openxc/shiftknob-hardware/docs/BOM_BottomPCB_v02.xls

Ford Motor Company | Research and Innovation Center |  |  |  |  | Please call to confirm any issues or questions before proceeding
BOM: | BottomPCB-v02
Date: | 2013-03-26
Assignee: | Zachary Nelson znelson1@ford.com
Item | QTY/BOARD | Reference Designation | Value | Description | Package | Manfr. or Distributor description/specs | Manfacturer | Manfr. P/N: | Distrutor | Distributor P/N
1 | 5 | C1, C2, C3, C4, C5 | 0.1uF | Capacitor | 0402 (1005 Metric) | CAP CER 0.1UF 16V 10% X5R 0402 | AVX Corporation | 0402YD104KAT2A | DIGIKEY | 478-1126-1-ND
2 | 2 | C10, C6 | 10uF | Capacitor - Polarized | 1206 (3216 Metric) | CAP TANT 10UF 16V 10% 1206 | Nichicon | F931C106KAA | DIGIKEY | 493-4147-1-ND
3 | 3 | LED1, LED2, LED3 | none | RGB LED - RIGHTANGLE | 4-SMD, No Lead | LED CHIP RGB 2.5X1.0X1.0MM SMD | Avago Technologies | HSMF-C113 | DIGIKEY | 516-2232-1-ND
4 | 1 | U1 (ATMEGA328) | none | IC - Atmega328 | 32-pin SMD | MCU AVR 32K FLASH 15MHZ 32-TQFP | Atmel | ATMEGA328P-15AZ | DIGIKEY | ATMEGA328P-15AZCT-ND
5 | 1 | Q1 | 16MHz | 16MHz clock | 3-SMD, Non-Standard | CER RESONATOR 16.0MHZ SMD | Murata Electronics North America | CSTCE16M0V53-R0 | DIGIKEY | 490-1198-1-ND
6 | 1 | IC2 | none | 7805 linear regulator | SOT-223 | IC REG LDO 5V .5A SOT-223 | Texas Instruments | UA78M05CDCYR | DIGIKEY | 296-12290-1-ND
7 | 5 | Q2, Q4, Q5, Q6 | none | MOSFET-NCHANNELSMD | SOT-23-3 | MOSFET N-CH 20V 4.2A SOT23 | Diodes Inc | DMG2302U-7 | DIGIKEY | DMG2302U-7DICT-ND
8 | 1 | Q3 | none | MOSFET-PCHANNELSMD | SOT-23-3 | MOSFET P-CH 20V 4.2A SOT-23 | Diodes Inc | DMP2305U-7 | DIGIKEY | DMP2305UDICT-ND
9 | 2 | D1, D2 | none | Schottky Diode | SOD123 | DIODE SCHOTTKY 0.5A 20V SOD-123 | ON Semiconductor | MBR0520LT3G | DIGIKEY | MBR0520LT3GOSCT-ND
10 | 1 | LED7 | none | Green LED | 0603 (1608 Metric) | LED 1.6X0.8MM 568NM GRN CLR SMD | Kingbright Corp | APT1608SGC | DIGIKEY | 754-1121-1-ND
11 | 1 | LED6 | none | Red LED | 0603 (1608 Metric) | LED 1.6X0.8MM 625NM RED CLR SMD | Kingbright Corp | APT1608EC | DIGIKEY | 754-1117-1-ND
12 | 3 | R2, R13, R14 | 10kΩ | Resistor | 0402 (1005 Metric) | RES 10K OHM 1/16W 5% 0402 SMD | Stackpole Electronics Inc | RMCF0402JT10K0 | DIGIKEY | RMCF0402JT10K0CT-ND
13 | 2 |  | 1kΩ | Resistor (for TX and RX LEDs) | 0402 (1005 Metric) | RES 1K OHM 1/16W 5% 0402 | Stackpole Electronics Inc | RMCF0402JT1K00 | DIGIKEY | RMCF0402JT1K00CT-ND
14 | 2 | RN1, RN2 | 150Ω | Resistor Array | 2008, Concave (0805) | RES ARRAY 150 OHM 4 RES 2008 | CTS Resistor Products | 743C083151JP | DIGIKEY | 743C083151JPCT-ND
15 | 1 | RN3 | 100Ω | Resistor Array | 2008, Concave (0805) | RES ARRAY 100 OHM 4 RES 2008 | CTS Resistor Products | 743C083101JP | DIGIKEY | 743C083101JPCT-ND
16 | 1 | BUTTON | none | Edge Button | 6.20mm x 2.55mm | SWITCH TACTILE SPST-NO 0.02A 15V | Panasonic Electronic Components | EVQ-P4H03B | DIGIKEY | P12305SCT-ND
17 | 2 | JP4 | none | Connector - Receptacle | 2.0mm pitch | CONN HEADER 2POS 2MM R/A SMD | Molex Inc | #5023520200 | DIGIKEY | WM7169CT-ND
18 | 1 | not on board | none | Connector - Plug | 2.0mm pitch | CONN 2.0 W/B REC HSG 2CKT | Molex Inc | #5023510200 | DIGIKEY | 5023510200-ND
19 | 1 | U6 | none | USB Vertical | Through Hole - Vertical | CONN MINI USB 5PIN VERT T/H | Wurth Electronics Inc | #651005136421 | DIGIKEY | 732-2735-ND
20 | 1 | U3 | none | FT232RL | 28-SSOP | IC USB FS SERIAL UART 28-SSOP | FTDI | FT232RL-REEL | DIGIKEY | 768-1007-1-ND
