openxc/shiftknob-hardware/docs/BOM_TopPCB_v02.xls

Ford Motor Company | Research and Innovation Center |  |  |  | Please call to confirm any issues or questions before proceeding
BOM: | TopPCB-v02
Date: | 2013-04-08
Assignee: | Zachary Nelson (313) 920-8701
Item | QTY/BOARD | Reference Designation | Value | Description | Package | Manfr. or Distributor description/specs | Manfacturer | Manfr. P/N: | Distrutor | Distributor P/N
1 | 2 | ARRAY1, ARRAY2 | 220Ω | Resistor Array | 2012 (5131 Metric), Concave | RES ARRAY 220 OHM 4 RES 2012 | CTS Resistor Products | 744C083221JP | DIGIKEY | 744C083221JPCT-ND
2 | 1 | C1 | 0.1uF | Capacitor | 0402 (1005 Metric) | CAP CER 0.1UF 16V 10% X5R 0402 | AVX Corporation | 0402YD104KAT2A | DIGIKEY | 478-1126-1-ND
3 | 1 | SHIFT1 | 74HC595D | 8-bit SHIFT REGISTER, output latch | 16-SOIC (0.154", 3.90mm Width) | IC 8BIT SHIFT REG 3ST-OUT 16SOIC | Texas Instruments | SN74HC595DR | DIGIKEY | 296-14857-1-ND
4 | 2 | LOWER, UPPER | none | 4-pin male header | 0.1" pitch
5 | 1 | 7SEGMENT | none | 7 Segment LED Display | 2 x 5 pin through hole | 7-Segment Display - LED (BLUE) | www.100LED.com | YSD-160AB3C-8 | Sparkfun | COM-09191
