openxc/shiftknob-hardware/docs/BottomPCB_schematic_v02.pdf

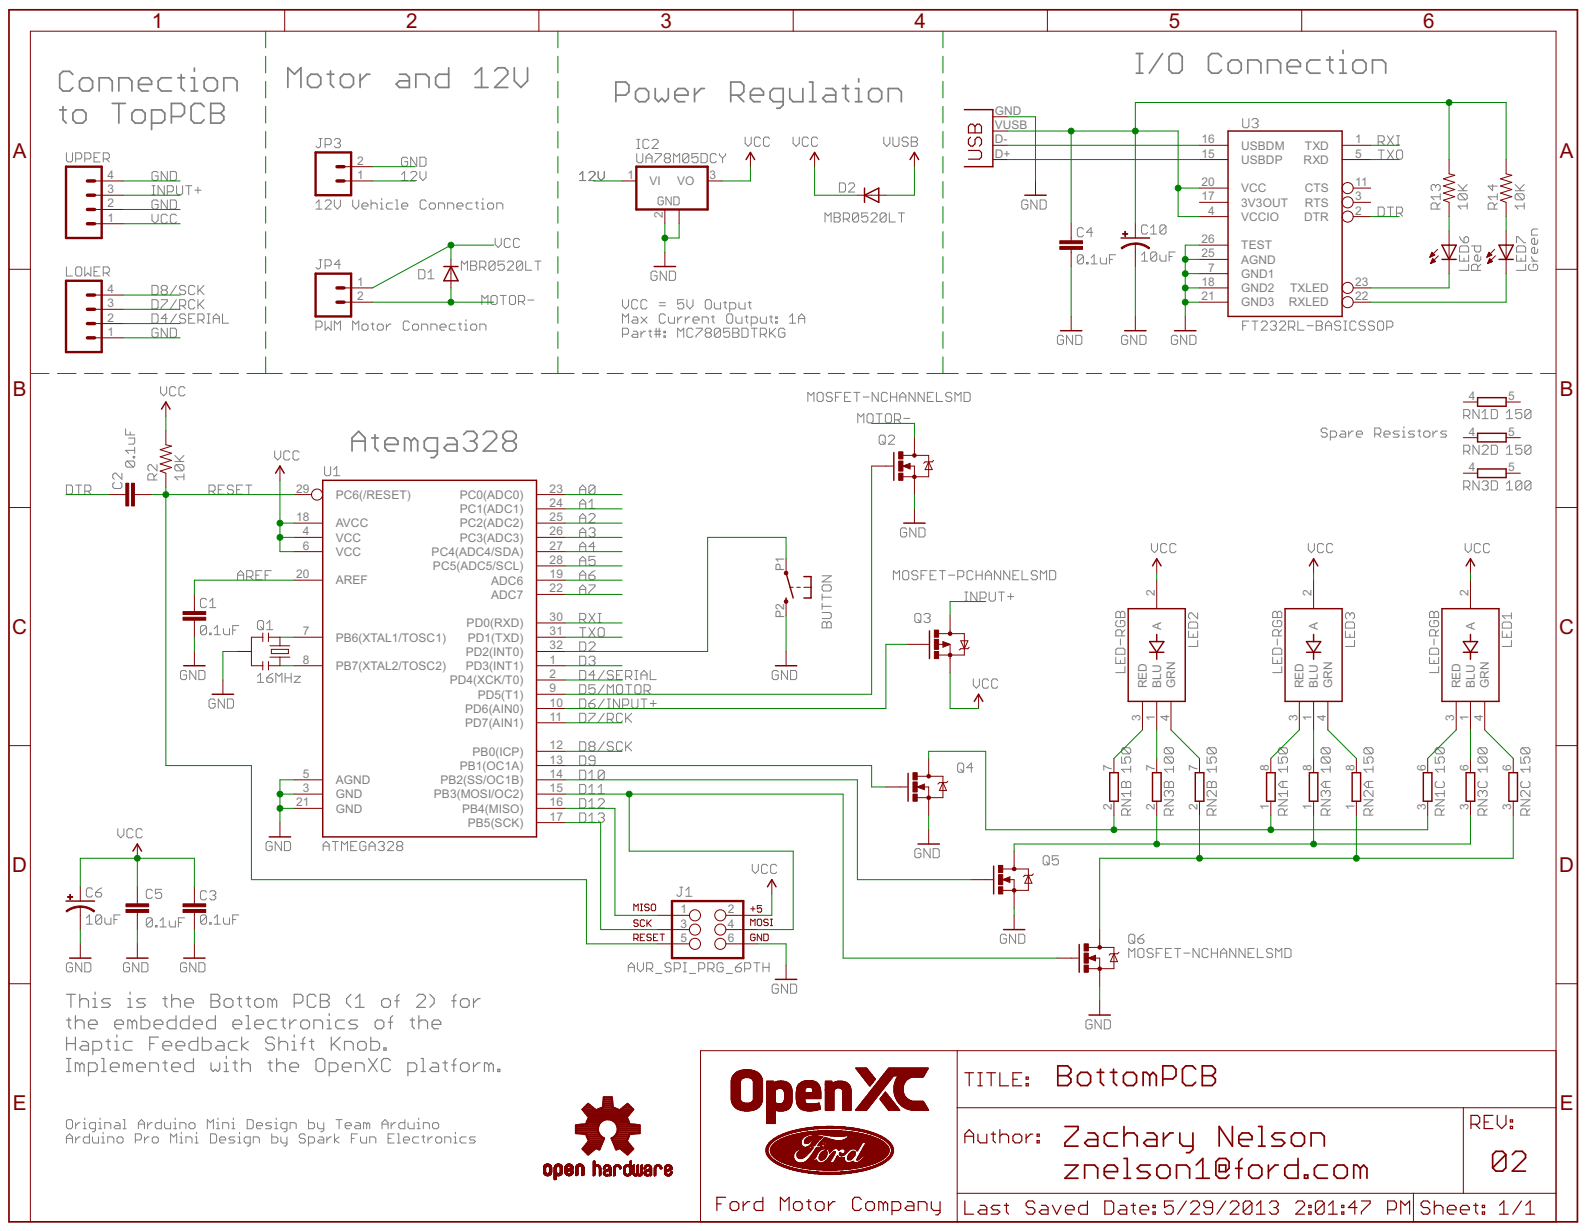
[picture p1: page 1]
