openxc/shiftknob-hardware/docs/TopPCB_schematic_v02.pdf

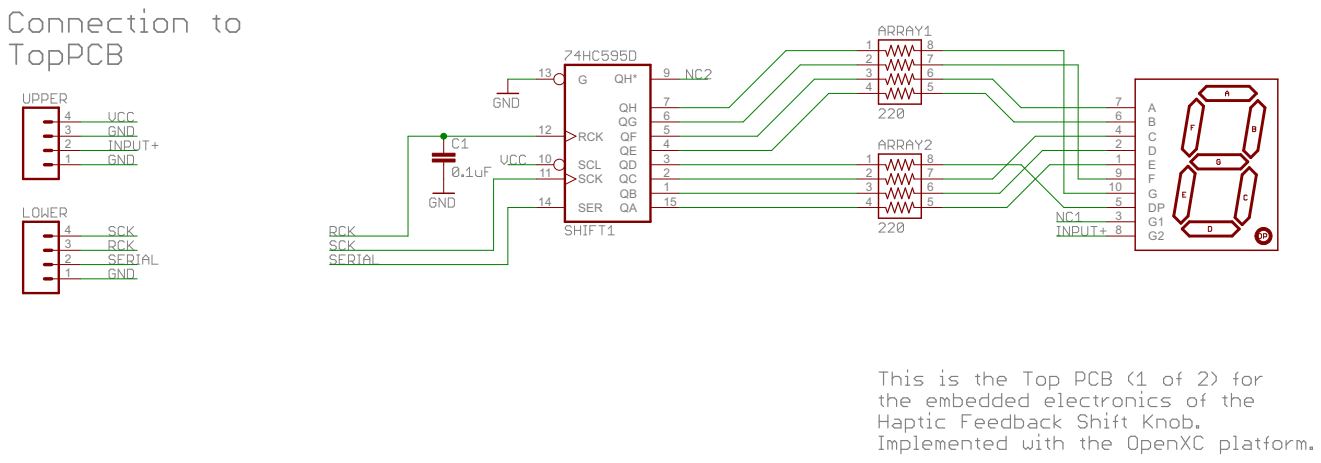
[picture p2: page 1]
