openxc/shiftknob-hardware/docs/BottomPCB_layout_v02.pdf

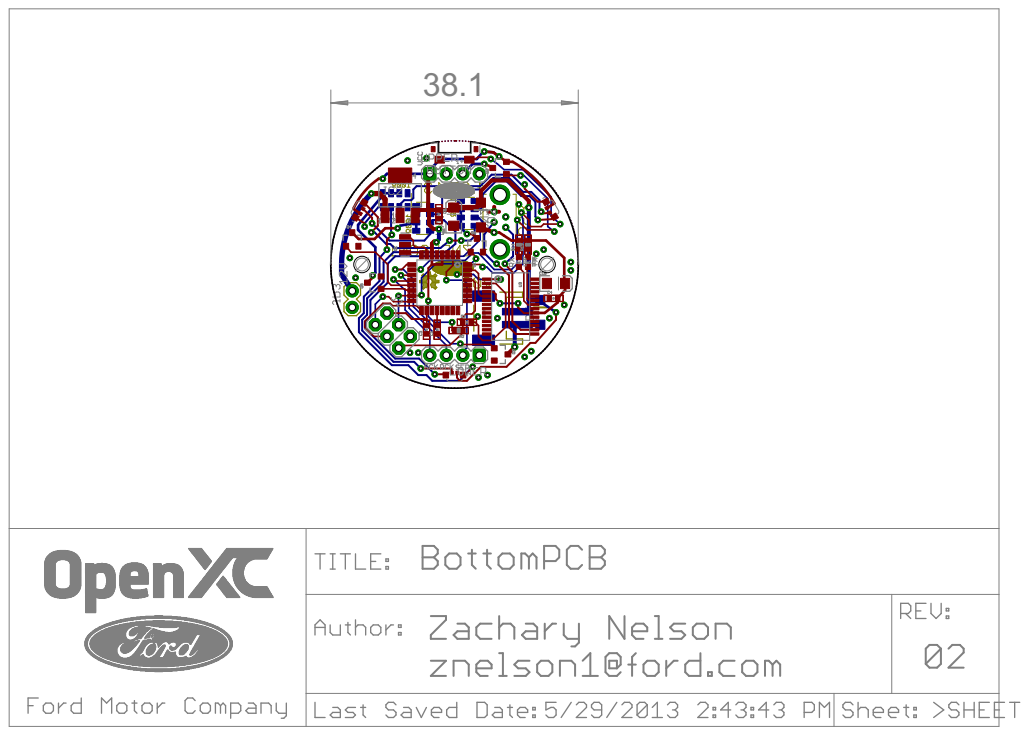
[picture p3: page 1]
