openxc/shiftknob-hardware/docs/TopPCB_layout_v02.pdf

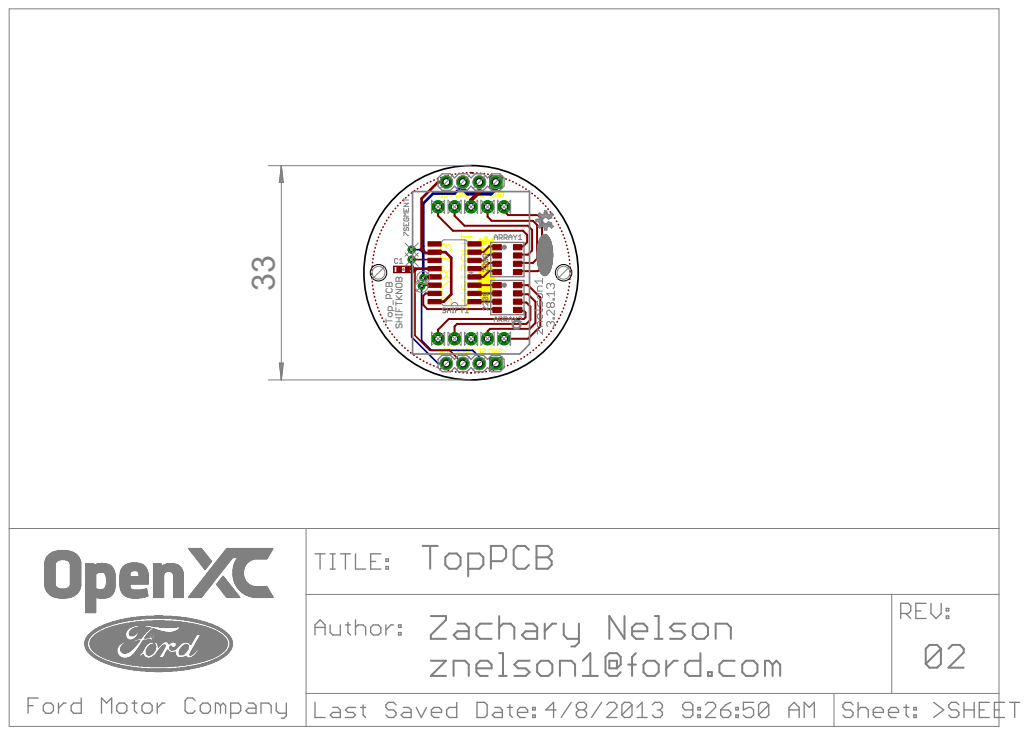
[picture p4: page 1]
