openxc/shiftknob-hardware/docs/BottomPCB_schematic_V01.pdf

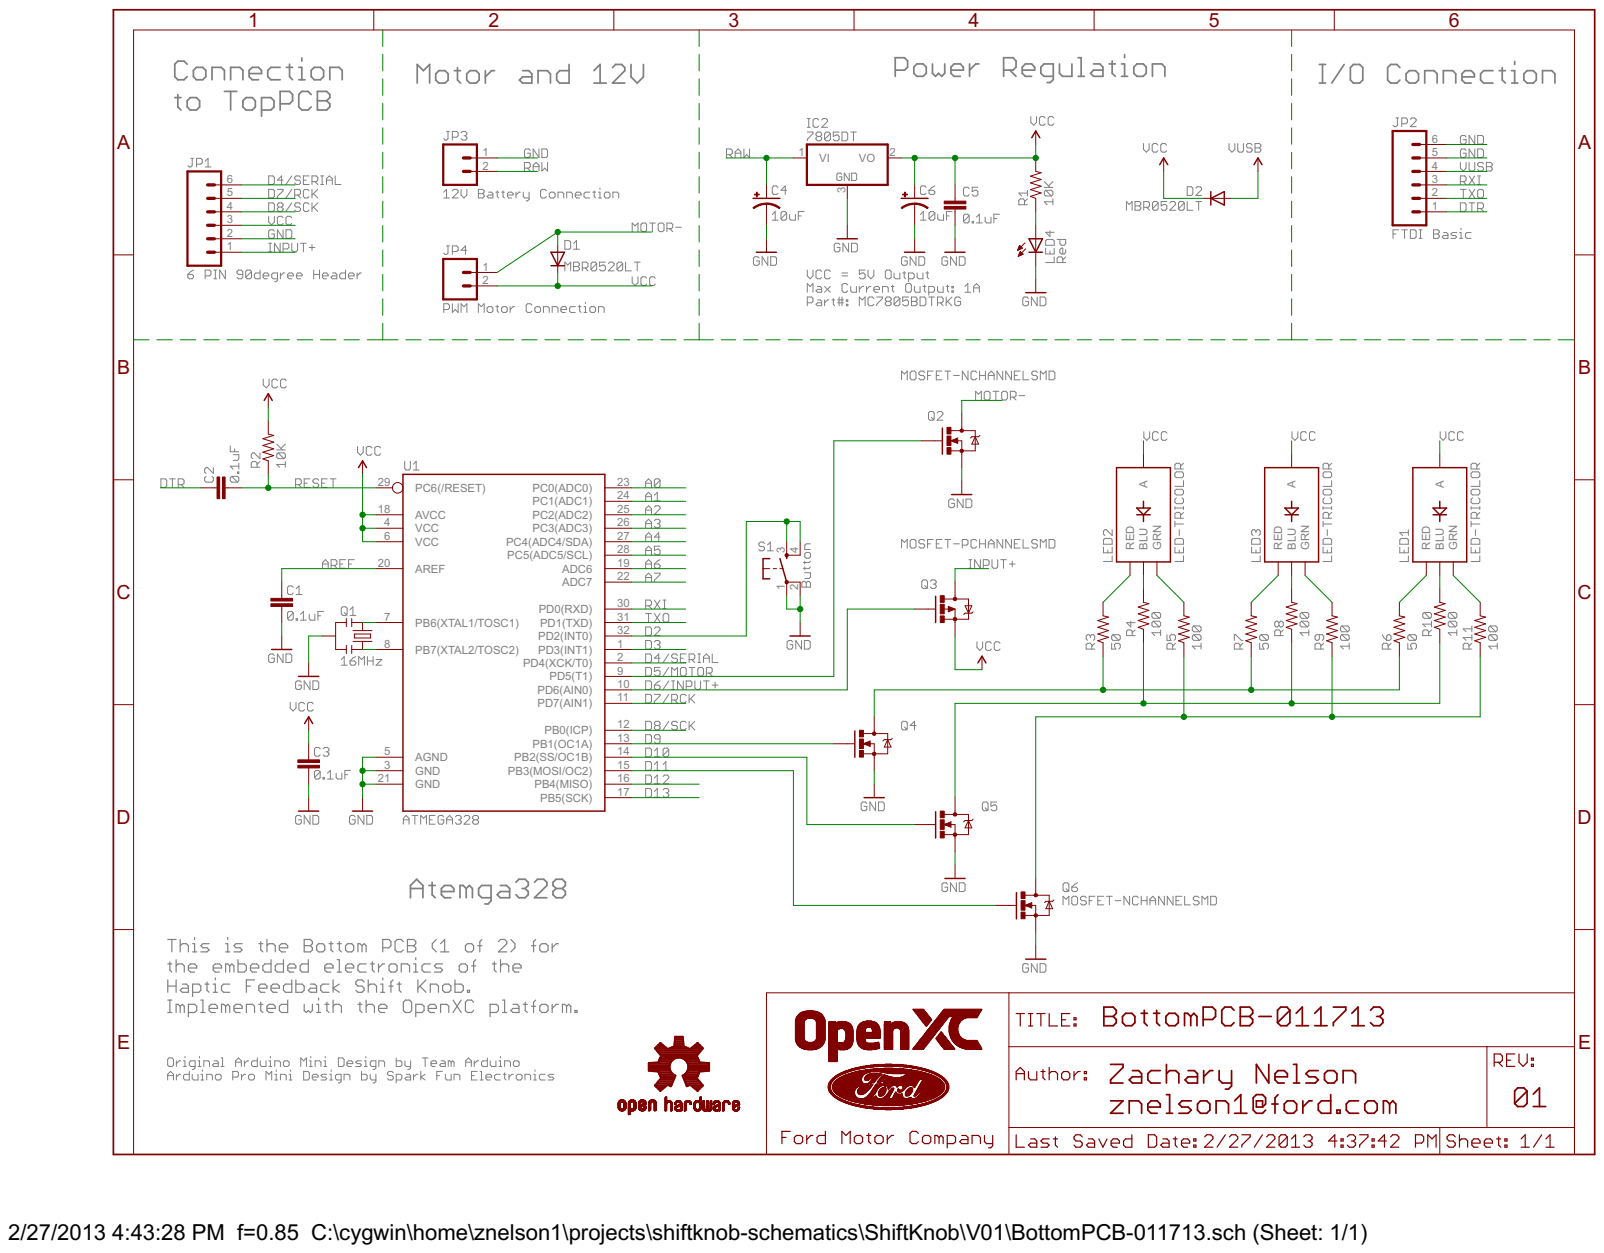
[picture p5: page 1]

2/27/2013 4:43:28 PM f=0.85 C:\cygwin\home\znelson1\projects\shiftknob-schematics\ShiftKnob\V01\BottomPCB-011713.sch (Sheet: 1/1)
