openxc/shiftknob-hardware/docs/TopPCB_schematic_V01.pdf

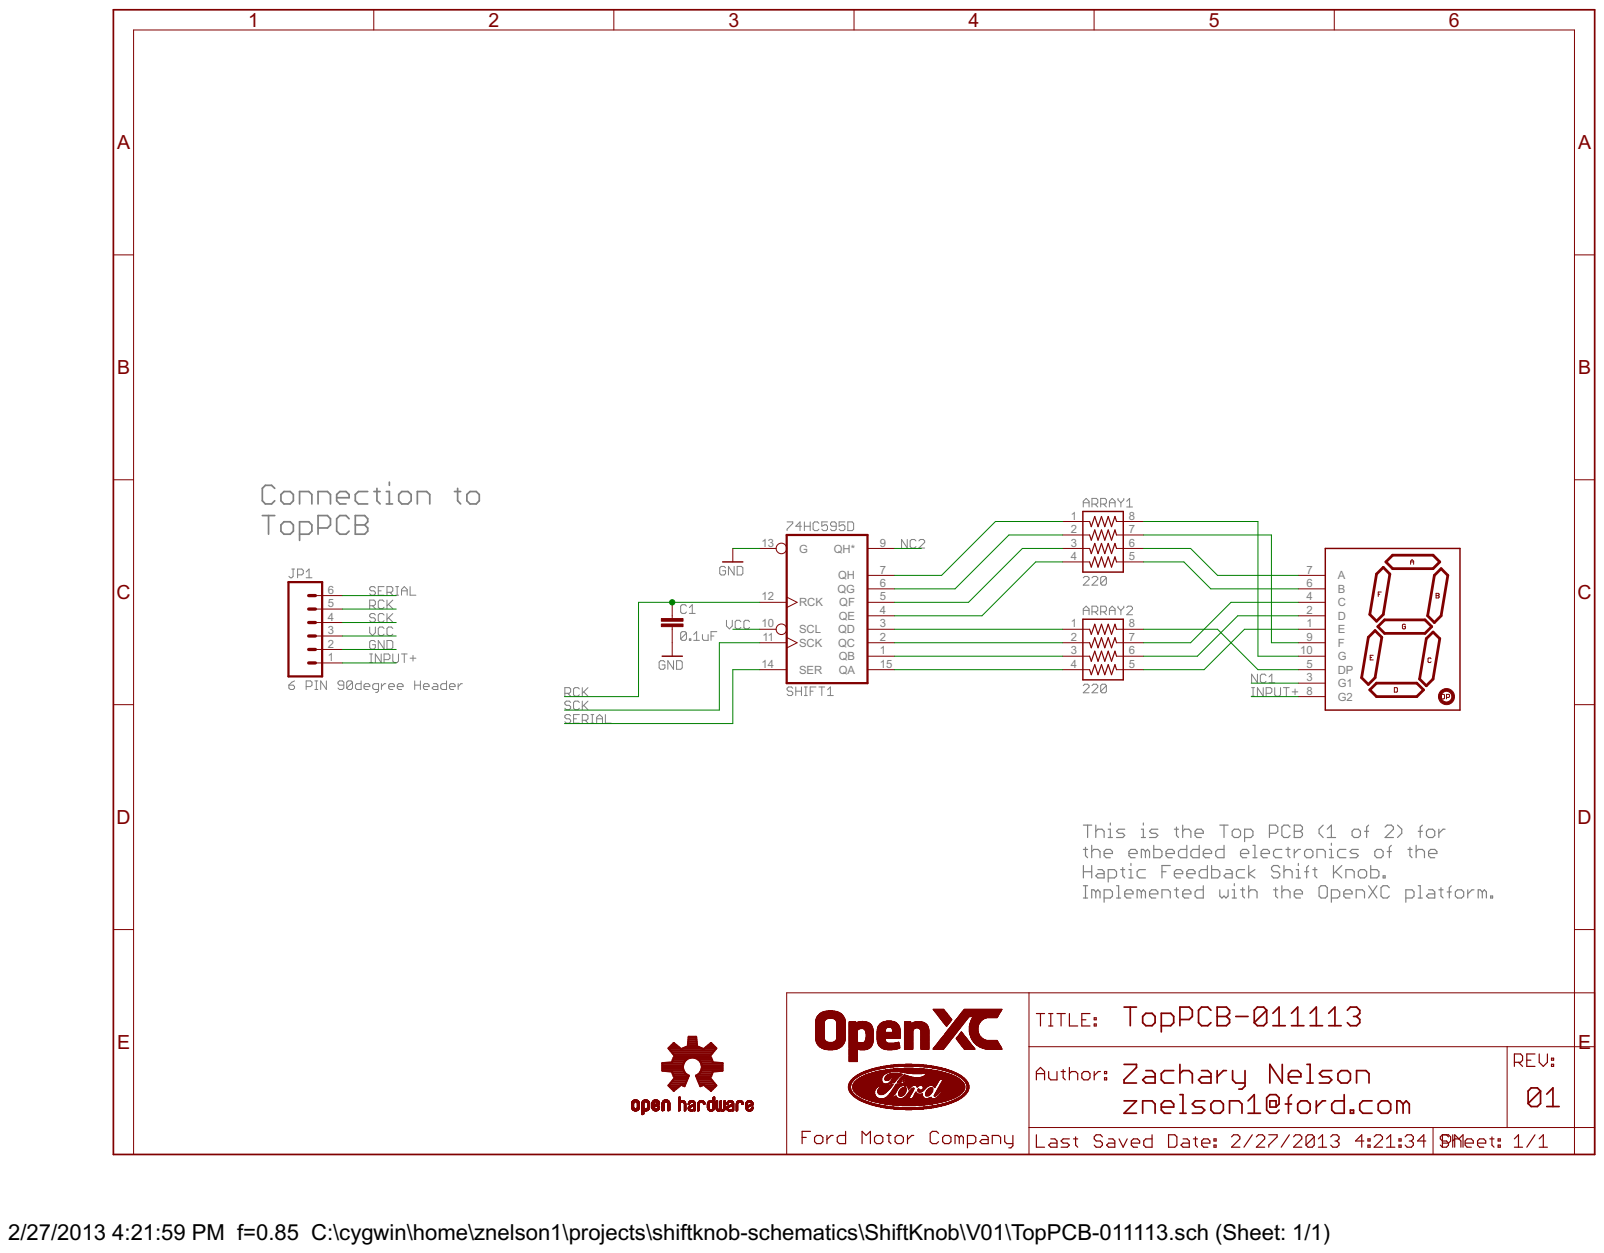
[picture p6: page 1]

2/27/2013 4:21:59 PM f=0.85 C:\cygwin\home\znelson1\projects\shiftknob-schematics\ShiftKnob\V01\TopPCB-011113.sch (Sheet: 1/1)
