openxc/shiftknob-hardware/docs/BottomPCB_layout_v01.pdf

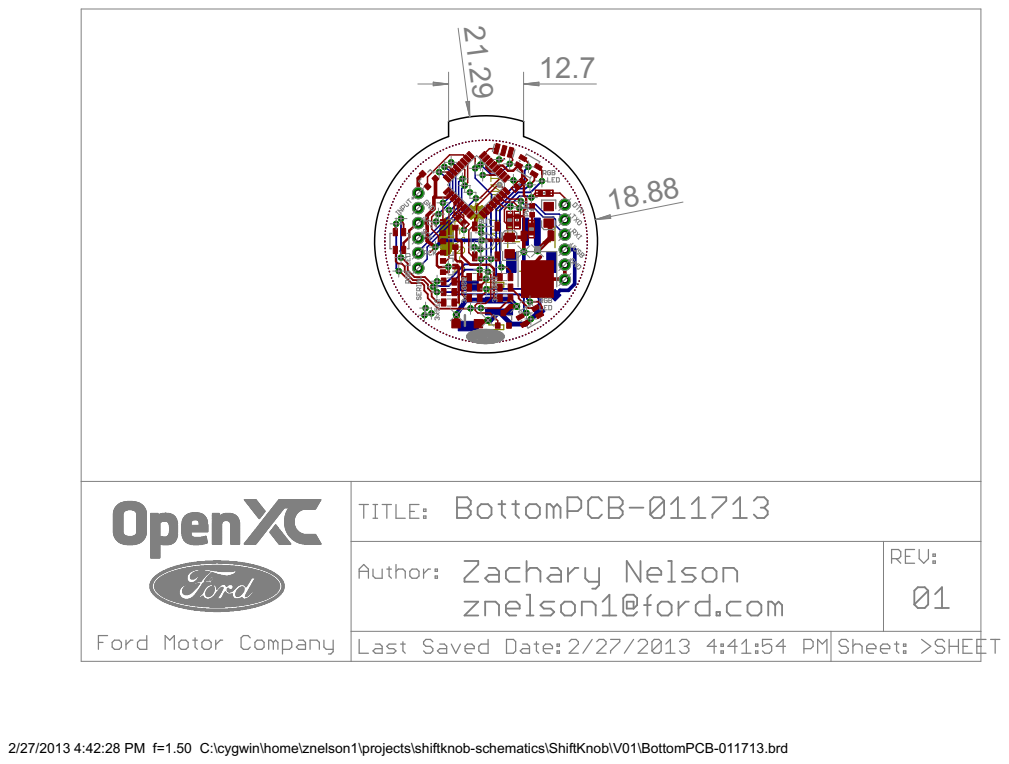
[picture p7: page 1]

2/27/2013 4:42:28 PM f=1.50 C:\cygwin\home\znelson1\projects\shiftknob-schematics\ShiftKnob\V01\BottomPCB-011713.brd
