openxc/shiftknob-hardware/TopPCB.brd

## EAGLE design TopPCB.brd (2013-04-08)

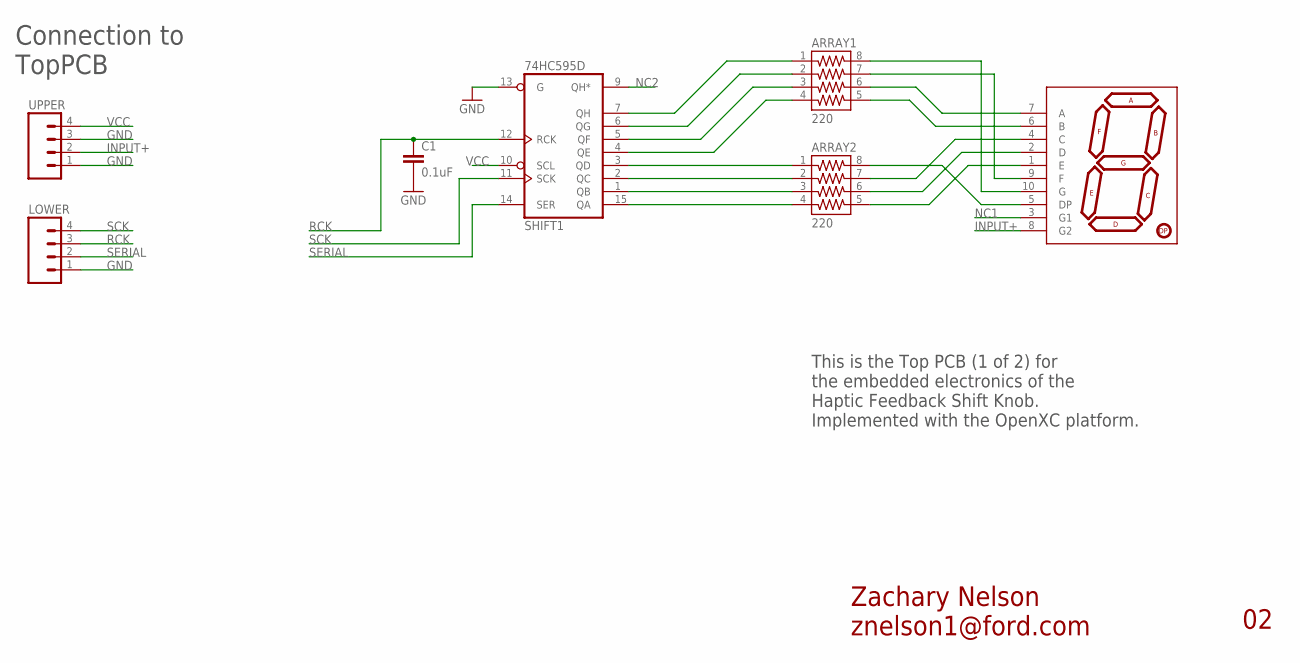
[picture p8: schematic TopPCB.sch]

Parts:
7SEGMENT: 7-SEGMENT-DISPLAY-1"-RED; 7-SEGMENT-1"PTH
ARRAY1, ARRAY2: 220; 744-8
C1: 0.1uF; 0402-CAP
LOWER: M04PTH; 1X04
SHIFT1: 74HC595D; SO16
UPPER: M04PTH; 1X04

Connections:
GND: C1.2, LOWER.1, SHIFT1.8 (GND), SHIFT1.13 (G), UPPER.1, UPPER.3
INPUT+: 7SEGMENT.8 (G2), UPPER.2
unnamed: 7SEGMENT.5 (DP), ARRAY2.8
unnamed: ARRAY2.3, SHIFT1.1 (QB)
unnamed: 7SEGMENT.1 (E), ARRAY2.5
unnamed: ARRAY2.2, SHIFT1.2 (QC)
unnamed: ARRAY2.1, SHIFT1.3 (QD)
unnamed: 7SEGMENT.4 (C), ARRAY2.7
unnamed: 7SEGMENT.6 (B), ARRAY1.5
unnamed: ARRAY2.4, SHIFT1.15 (QA)
unnamed: ARRAY1.4, SHIFT1.4 (QE)
unnamed: ARRAY1.3, SHIFT1.5 (QF)
unnamed: ARRAY1.2, SHIFT1.6 (QG)
unnamed: ARRAY1.1, SHIFT1.7 (QH)
unnamed: 7SEGMENT.7 (A), ARRAY1.6
unnamed: 7SEGMENT.9 (F), ARRAY1.7
unnamed: 7SEGMENT.10 (G), ARRAY1.8
unnamed: 7SEGMENT.2 (D), ARRAY2.6
NC1: 7SEGMENT.3 (G1)
NC2: SHIFT1.9 (QH*)
RCK: C1.1, LOWER.3, SHIFT1.12 (RCK)
SCK: LOWER.4, SHIFT1.11 (SCK)
SERIAL: LOWER.2, SHIFT1.14 (SER)
VCC: SHIFT1.10 (SCL), SHIFT1.16 (VCC), UPPER.4

Notes on the sheet:
Zachary Nelson znelson1@ford.com
This is the Top PCB (1 of 2) for the embedded electronics of the Haptic Feedback Shift Knob. Implemented with the OpenXC platform.
Connection to TopPCB

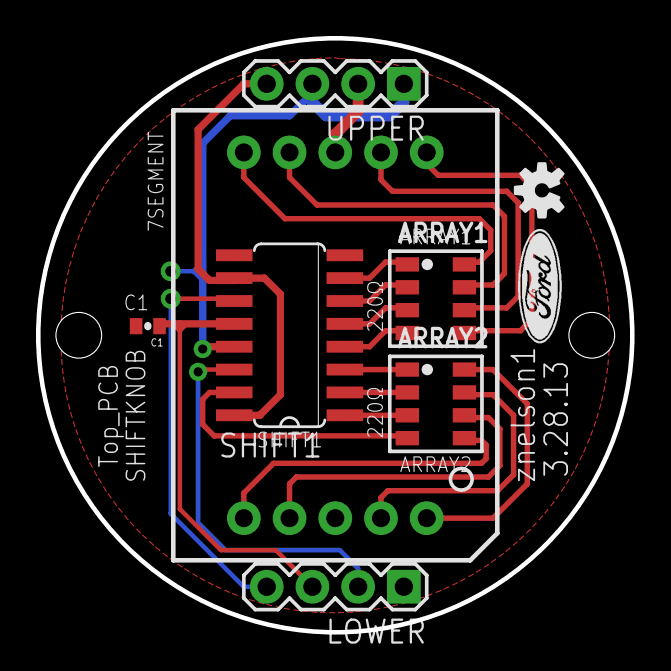
[picture p9: board TopPCB.brd from above]

Board: 2 copper layers, 33.0 x 33.0 mm, 10 parts (1 on the bottom side), 22 nets.

Other parts of the board:
U$1, U$2: OSHW-LOGOS; OSHW-LOGO-S
U$3: DOCFIELD
