openxc/shiftknob-hardware/BottomPCB.brd

## EAGLE design BottomPCB.brd (2013-05-29)

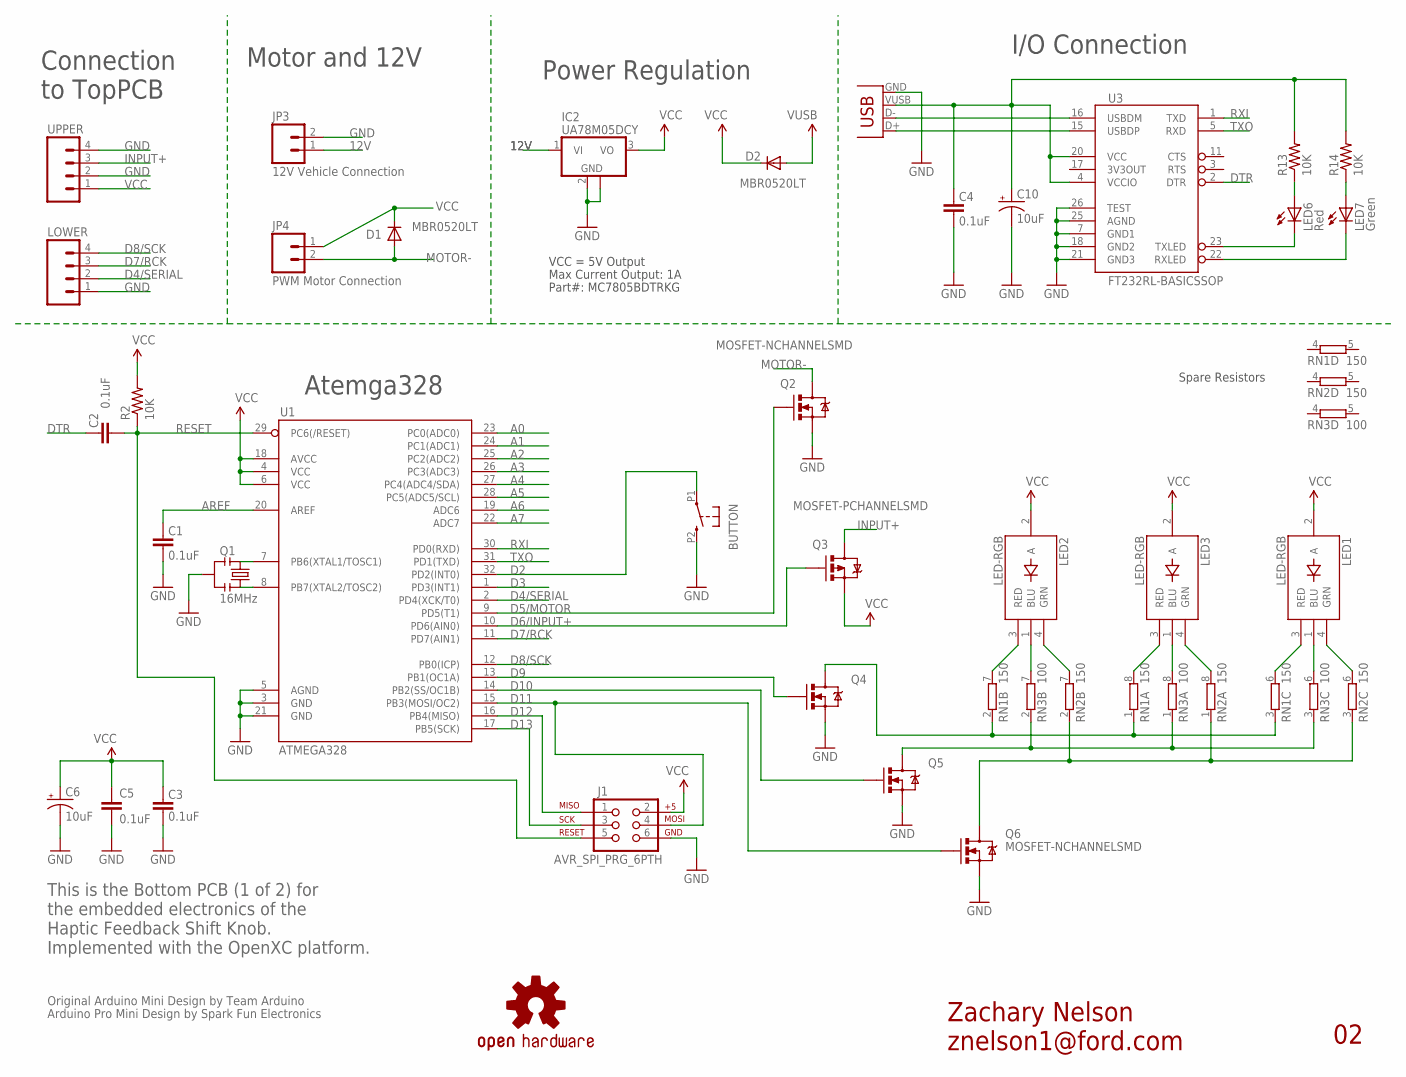
[picture p10: schematic BottomPCB.sch]

Parts:
BUTTON: BUTTON_EDGE
C1, C2, C3, C4, C5: 0.1uF; 0402-CAP
C6, C10: 10uF; EIA3216
D1, D2: MBR0520LT; SOD123
IC2: UA78M05DCY; SOT223
J1: AVR_SPI_PRG_6PTH; 2X3
JP3: 12V Vehicle Connection; 1X02
JP4: PWM Motor Connection; JST-2-SMD
LED1, LED2, LED3: LED-RGB; LED-RGB_SMD-RIGHTANGLE
LED6: Red; LED-0603
LED7: Green; LED-0603
LOWER: M04PTH; 1X04
Q1: 16MHz; RESONATOR-SMD
Q2, Q4, Q5, Q6: MOSFET-NCHANNELSMD; SOT23-3
Q3: MOSFET-PCHANNELSMD; SOT23-3
R2, R13, R14: 10K; 0402-RES
RN1, RN2: 150; EXBS8V
RN3: 100; EXBS8V
U1: ATMEGA328; TQFP32-08
U3: FT232RL-BASICSSOP; SSOP28DB
U6: USB-MINI-B_VERTICAL
U$3: OSHW-LOGOS; OSHW-LOGO-S
UPPER: M04PTH; 1X04

Connections:
12V: IC2.1 (VI), JP3.1
A0: U1.23 (PC0(ADC0))
A1: U1.24 (PC1(ADC1))
A2: U1.25 (PC2(ADC2))
A3: U1.26 (PC3(ADC3))
A4: U1.27 (PC4(ADC4/SDA))
A5: U1.28 (PC5(ADC5/SCL))
A6: U1.19 (ADC6)
A7: U1.22 (ADC7)
AREF: C1.2, U1.20 (AREF)
D2: BUTTON.P1 (1), U1.32 (PD2(INT0))
D3: U1.1 (PD3(INT1))
D4/SERIAL: LOWER.2, U1.2 (PD4(XCK/T0))
D5/MOTOR: Q2.1 (G), U1.9 (PD5(T1))
D6/INPUT+: Q3.1 (G), U1.10 (PD6(AIN0))
D7/RCK: LOWER.3, U1.11 (PD7(AIN1))
D8/SCK: LOWER.4, U1.12 (PB0(ICP))
D9: Q4.3 (D), RN1.1, RN1.2 (1), RN1.3 (1)
D10: Q5.3 (D), RN3.1, RN3.2 (1), RN3.3 (1)
D11: Q6.3 (D), RN2.1, RN2.2 (1), RN2.3 (1)
D12: J1.1, U1.16 (PB4(MISO))
D13: J1.3, U1.17 (PB5(SCK))
DTR: C2.2, U3.2 (DTR)
GND: BUTTON.P2 (2), C1.1, C3.1, C4.1, C5.2, C6.C (-), C10.C (-), IC2.2 (GND), IC2.4 (GND), J1.6, JP3.2, LOWER.1, Q1.2, Q2.2 (S), Q4.2 (S), Q5.2 (S), Q6.2 (S), U1.3 (GND), U1.5 (AGND), U1.21 (GND), U3.7 (GND1), U3.18 (GND2), U3.21 (GND3), U3.25 (AGND), U3.26 (TEST), U6.GND, UPPER.2, UPPER.4
INPUT+: Q3.3 (D), UPPER.3
MOTOR-: D1.A, JP4.2 (1), Q2.3 (D)
unnamed: Q1.1, U1.8 (PB7(XTAL2/TOSC2))
unnamed: Q1.3, U1.7 (PB6(XTAL1/TOSC1))
unnamed: LED2.3 (RED), RN1.7 (2)
unnamed: LED2.4 (GRN), RN2.7 (2)
unnamed: LED3.3 (RED), RN1.8 (2)
unnamed: LED1.1 (BLU), RN3.6 (2)
unnamed: LED3.4 (GRN), RN2.8 (2)
unnamed: LED1.3 (RED), RN1.6 (2)
unnamed: LED1.4 (GRN), RN2.6 (2)
unnamed: Q4.1 (G), U1.13 (PB1(OC1A))
unnamed: Q5.1 (G), U1.14 (PB2(SS/OC1B))
unnamed: J1.4, Q6.1 (G), U1.15 (PB3(MOSI/OC2))
unnamed: LED2.1 (BLU), RN3.7 (2)
unnamed: LED3.1 (BLU), RN3.8 (2)
unnamed: U3.15 (USBDP), U6.D+
unnamed: U3.16 (USBDM), U6.D-
unnamed: LED6.A, R13.1
unnamed: LED7.A, R14.1
RESET: C2.1, J1.5, R2.1, U1.29 (PC6(/RESET))
RXI: U1.30 (PD0(RXD)), U3.1 (TXD)
RXLED1: LED7.C, U3.22 (RXLED)
TXLED1: LED6.C, U3.23 (TXLED)
TXO: U1.31 (PD1(TXD)), U3.5 (RXD)
VCC: C3.2, C5.1, C6.A (+), D1.C, D2.C, IC2.3 (VO), J1.2, JP4.1 (2), LED1.2 (A), LED2.2 (A), LED3.2 (A), Q3.2 (S), R2.2, U1.4 (VCC), U1.6 (VCC), U1.18 (AVCC), UPPER.1
VUSB: C4.2, C10.A (+), D2.A, R13.2, R14.2, U3.4 (VCCIO), U3.20 (VCC), U6.VUSB (VBUS)

Notes on the sheet:
Zachary Nelson znelson1@ford.com
Original Arduino Mini Design by Team Arduino
Arduino Pro Mini Design by Spark Fun Electronics
Max Current Output: 1A
VCC = 5V Output
Part#: MC7805BDTRKG
Power Regulation
I/O Connection
Motor and 12V
Atemga328
Connection to TopPCB
This is the Bottom PCB (1 of 2) for the embedded electronics of the Haptic Feedback Shift Knob. Implemented with the OpenXC platform.
Spare Resistors

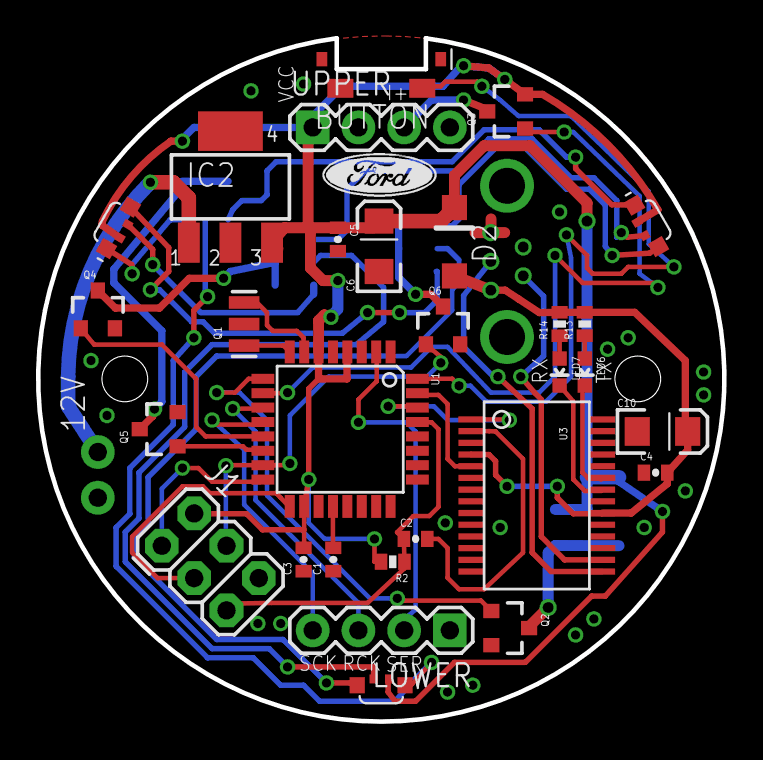
[picture p11: board BottomPCB.brd from above]

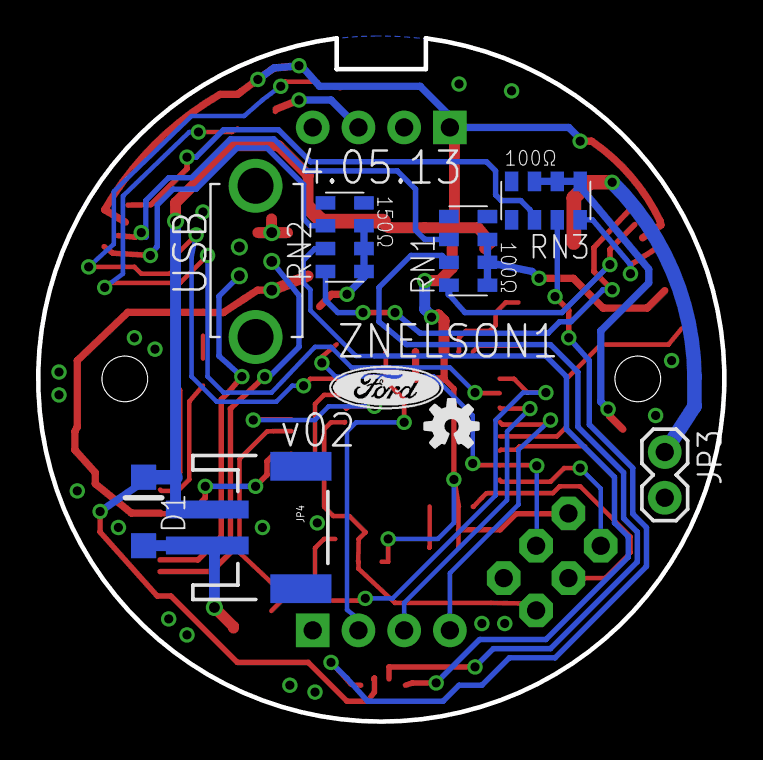
[picture p12: board BottomPCB.brd from below]

Board: 2 copper layers, 38.1 x 38.0 mm, 38 parts (8 on the bottom side), 42 nets.

Other parts of the board:
U$1: DOCFIELD
