openxc/shiftknob-hardware/(commit log)

2013-01-04 initial BOM commit
2013-01-14 creating project folders
    [Arduino-Pro-Mini-v13.brd, Arduino-Pro-Mini-v13.sch, Bottom_rev1.sch, Top_rev1.sch]
2013-01-14 added all components and connections for Top PCB.
    [Top_rev1.brd, Top_rev1.sch]
2013-01-15 layout board and route traces. changed a few signals between shift register and 7 segment
    [Top_rev1.brd, Top_rev1.sch]
2013-01-15 remove ground connection on pin 9 of shift register
    [Top_rev1.brd, Top_rev1.sch]
2013-01-18 remove BottomPCB folder, finished version 1 of TopPCB, moved Bottom_rev1 to TopPCB folder, first commit of Bottom pcb work.
    [Bottom_rev1.brd, Bottom_rev1.sch, Top_rev1.brd, Top_rev1.sch]
2013-01-18 change folder/file structure to match SVL PCB guidelines
    [Bottom_rev1.brd, Bottom_rev1.sch, Top_rev1.brd, Top_rev1.sch]
2013-01-18 more folder/file changes to match SVL PCB guidelines
    [BottomPCB-011713.brd, BottomPCB-011713.sch, TopPCB-011113.brd, TopPCB-011113.sch]
2013-01-18 all components added to BottomPCB schematic. added: MOSFETs, RGB LEDs x2, Motor connector, 7805 regulator
    [BottomPCB-011713.brd, BottomPCB-011713.sch, TopPCB-011113.brd]
2013-01-18 change battery and motor connectors to SMT parts
    [BottomPCB-011713.sch]
2013-01-18 add 1 more RGB led. add FETs for controlling 3 LEDs.
    [BottomPCB-011713.sch]
2013-01-18 switch pins on battery connector and motor connector to match footprint
    [BottomPCB-011713.sch]
2013-01-18 all components on the board with no traces
    [BottomPCB-011713.brd]
2013-01-22 add pullup resistor to button. adding traces to board.
    [BottomPCB-011713.brd, BottomPCB-011713.sch]
2013-01-22 minor board adjustment. increase trace width of Vcc.
    [TopPCB-011113.brd]
2013-01-22 add more traces to brd layout. not yet finished.
    [BottomPCB-011713.brd, BottomPCB-011713.sch]
2013-01-23 add schottky diode to hand usb power auto selection
    [BottomPCB-011713.sch]
2013-01-23 all traces done except ground.
    [BottomPCB-011713.brd]
2013-01-24 all traces complete. all GND pins connected and clear.
    [BottomPCB-011713.brd, BottomPCB-011713.sch]
2013-01-24 increase diameter of board to 33 mm
    [BottomPCB-011713.brd]
2013-01-24 add BOM files.
    [BOM_BottomPCB-011713.csv, BOM_TopPCB-011113.csv]
2013-01-24 remove centerline
    [BottomPCB-011713.brd]
2013-01-25 add gnd trace on bottom layer. increase width of input+
    [TopPCB-011113.brd]
2013-01-25 name components, add silk screen labels, copy name-date-logo to bottom layer, increase board diameter to 33mm
    [TopPCB-011113.brd, TopPCB-011113.sch]
2013-01-25 increase isolation on ground pour. move labels
    [TopPCB-011113.brd]
2013-01-25 add open hardware logo
    [TopPCB-011113.brd]
2013-01-25 preliminarily finalized. added silk screen labels. may still add mounting holes
    [BottomPCB-011713.brd, BottomPCB-011713.sch]
2013-01-25 minor tweak
    [BottomPCB-011713.brd, BottomPCB-011713.sch]
2013-01-28 redo outer boundary of board. increase overall size and add locating features for housing integration.
    [BottomPCB-011713.brd]
2013-01-28 add Ford logo to the top of the board.
    [BottomPCB-011713.brd]
2013-01-28 remove csv BOM and resave as .txt
    [BOM_BottomPCB-011713.csv, BOM_TopPCB-011113.csv]
2013-01-28 adjust silk screen for vector font.
    [TopPCB-011113.brd]
2013-01-28 adjust silk screen layer for large font size.
    [BottomPCB-011713.brd]
2013-01-28 run DRC test and fix all issues.
    [BottomPCB-011713.brd]
2013-01-29 change 6 pin connector to match bottomPCB. run DRC and correct issues. move dimension callout to Document layer.
    [TopPCB-011113.brd, TopPCB-011113.sch]
2013-01-29 commit of V01 fab files
    [BottomPCB-011713_centroid.csv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]
2013-01-29 change diodes to match. add silk screen for polarity marking.
    [BottomPCB-011713.brd, BottomPCB-011713.sch]
2013-01-29 initial commit of excel BOMs
    [BOM_BottomPCB-011713.xls, BOM_TopPCB-011113.xls]
2013-01-29 redo Gerber files. with changed components and added silk screens.
    [BottomPCB-011713.brd, BottomPCB-011713.dxf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]
2013-01-30 move molex connectors on board to allow for better spacing. regenerate gerber files.
    [BottomPCB-011713.brd, BottomPCB-011713.dxf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]
2013-01-30 resize board perimeter. redo fab files.
    [BottomPCB-011713.brd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]
2013-01-30 changed the outer board perimeter one last time. V01 of bottom board finalized. regenerated fab files.
    [BottomPCB-011713.brd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]
2013-02-01 minor change to BOM.
    [BOM_BottomPCB-011713.xls]
2013-02-01 change border thickenss to .008"
    [BottomPCB-011713.brd]
2013-02-02 add to changeOrder: remove pull-up resistor on button and use internal pullup resistor on atmega328
2013-02-07 attach button to arduino pin 2 rather than 12 to use internal interrupt. adjust board accordingly. remove resistor and use internal resistor of atemga328.
    [BottomPCB-011713.brd, BottomPCB-011713.sch]
2013-02-07 final Gerber file generation for V01 with button interrupt pin change.
    [BottomPCB-011713_centroid.csv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]
2013-02-07 change outer profile to be .010 to match BatchPCB DRC check.
    [TopPCB-011113.brd]
2013-02-07 regenerate gerber files for top board. update change order. all changes made.
    [TopPCB-011113.GBL, TopPCB-011113.GBO, TopPCB-011113.GBS, TopPCB-011113.GTL, TopPCB-011113.GTO, TopPCB-011113.GTS]
2013-02-08 final finalized versions of boards and fab files.
    [BottomPCB-011713.brd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]
2013-02-14 fix board layout and schematic to properly setup MOSFETs. regenerate Gerber files. Change N-Channel MOSFET to P-Channel for 7segment brightness control (INPUT+)
    [BottomPCB-011713.brd, BottomPCB-011713.sch, BottomPCB-011713_centroid.csv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]
2013-02-14 add Pchannel SMD MOSFET to BOM.
    [BOM_BottomPCB-011713.xls]
2013-02-27 update schematics with new Ford frame.
    [BottomPCB-011713.brd, BottomPCB-011713.sch, TopPCB-011113.brd, TopPCB-011113.sch]
2013-03-12 update with new frames and printed drawings for assembly.
    [BOM_BottomPCB-011713.xls, BOM_TopPCB-011113.xls, BottomPCB-011713.brd, BottomPCB-011713.sch, TopPCB-011113.brd, TopPCB-011113.sch]
2013-03-19 update everything before moving on to V02.
    [BOM_BottomPCB-011713.xls, BOM_TopPCB-011113.xls]
2013-03-19 remove unneeded files.
    [BottomPCB-011713.dxf]
2013-03-19 move all files up one directory for shiftKnob PCBs. use tags for versioning rather than folders.
    [BOM_BottomPCB-011713.xls, BOM_TopPCB-011113.xls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]
2013-03-19 remove time stamp from file names
    [BOM_BottomPCB.xls, BOM_TopPCB.xls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]
2013-03-20 add ICSP 6-pin header to schematic.
    [BottomPCB.brd, BottomPCB.sch]
2013-03-20 fixed silk screen marking for motor diode.
    [BottomPCB.brd]
2013-03-20 change red LED resistance from 50ohm to 100ohm.
    [BottomPCB.brd, BottomPCB.sch]
2013-03-20 remove power LED and resistor. not needed as RGB leds turn on when 5V is applied during startup.
    [BottomPCB.brd, BottomPCB.sch]
2013-03-21 finish the schematic for the FTDI chip. Need to rework the board layout still.
    [BottomPCB.brd, BottomPCB.sch]
2013-03-22 switch out RGB LEDs for Right-Angle RGBs from FORD_frames library. Still need to fix layout.
    [BottomPCB.brd, BottomPCB.sch]
2013-03-26 add resistor arrays. clear off board layout and begin moving components.
    [BOM_BottomPCB.xls, BOM_TopPCB.xls, BottomPCB.brd, BottomPCB.sch]
2013-03-27 bring up to date. schematic almost finalized.
    [BOM_TopPCB.xls, BottomPCB.brd, BottomPCB.sch]
2013-03-28 add right angle button to schematic.
    [BottomPCB.sch]
2013-03-28 move C1, add (2) 0.1in holes for assembly and rework silk screens. move PCB to be centered at .85x.85 like bottomPCB
    [TopPCB.brd]
2013-03-28 use (2) 4 pin connectors rather than a 6 pin connector. Board layout and schematic preliminarily complete.
    [TopPCB.brd, TopPCB.sch]
2013-04-01 add 0.1" holes in bottom PCB.
    [BottomPCB.brd, BottomPCB.sch]
2013-04-01 redo silk screen pin labels. DRC checks out OK.
    [TopPCB.brd, TopPCB.sch]
2013-04-01 remove 6 pin header. add (2) 4 pin headers and place in the correct location to match TopPCB.
    [BottomPCB.brd, BottomPCB.sch]
2013-04-01 swap out button for edge_mount button in Ford_frames library.
    [BottomPCB.brd, BottomPCB.sch]
2013-04-02 everything on the board. need to route traces.
    [BottomPCB.brd, BottomPCB.sch]
2013-04-03 reworked the board layout. power traces complete.
    [BottomPCB.brd]
2013-04-04 fix VCC connection on RGB LEDs. Connection was not previously made between pin2 and VCC on each LED.
    [BottomPCB.sch]
2013-04-04 change 12V connection to 2 through hole solder points.
    [BottomPCB.sch]
2013-04-04 swap pins on button for easier board layout.
    [BottomPCB.sch]
2013-04-04 all traces done except motor connection and RGB LEDs.
    [BottomPCB.brd]
2013-04-05 swap pins on motor connection. add junctions where necessary. reorganize resistors for easier board layout.
    [BottomPCB.sch]
2013-04-05 board layout done. DRC check complete and all errors fixed. Only silk screens remaining.
    [BottomPCB.brd]
2013-04-05 Bottom board layout is finalized. 1st attempt at generating gerber files failed BatchPCB test.
    [BottomPCB.brd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]
2013-04-08 updated ground plane to pass DRC bot in BatchPCB. Gerber files generated for Top and Bottom. Everything passed BatchPCB test.
    [BottomPCB.brd, BottomPCB.sch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]
2013-04-08 update BOMs with all components for v02
    [BOM_BottomPCB.xls, BOM_TopPCB.xls]
2013-04-08 move silk screens for better visibility.
    [BottomPCB.brd, BottomPCB.sch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]
2013-04-18 add v02 and v01 docs.
    [BOM_BottomPCB_v01.xls, BOM_BottomPCB_v02.xls, BOM_TopPCB_v01.xls, BOM_TopPCB_v02.xls, BottomPCB.brd, TopPCB.sch]
2013-05-29 fix TX/RX issue on v02 board schematic and layout.
    [BOM_BottomPCB_v02.xls, BottomPCB.brd, BottomPCB.sch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]
2013-05-29 fix board layout to match OSH Park DRU check. regenerate gerber files including the new .GKO outline file needed for OSH.
    [BottomPCB.brd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]
2013-06-05 update BOM.
    [BOM_TopPCB_v02.xls]
2013-06-10 update BOMs.
    [BOM_BottomPCB_v01.xls, BOM_BottomPCB_v02.xls, BOM_TopPCB_v01.xls, BOM_TopPCB_v02.xls]
2013-06-11 remove Arduino Pro Mini design files.
    [Arduino-Pro-Mini-v13.brd, Arduino-Pro-Mini-v13.sch]
2013-06-11 remove intial BOM. Out of date and not needed.
2013-06-11 cleanup Fab_files and remove unneccesary files.
    [BottomPCB_centroid.csv, TopPCB_centroid.csv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]
2013-06-11 Move everything to the top level.
    [BOM_BottomPCB_v01.xls, BOM_BottomPCB_v02.xls, BOM_TopPCB_v01.xls, BOM_TopPCB_v02.xls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]
2013-06-11 fix typo for PCB BOMs.
